iuryeng/TecProto/projetoShield/interfaceGrafica.png

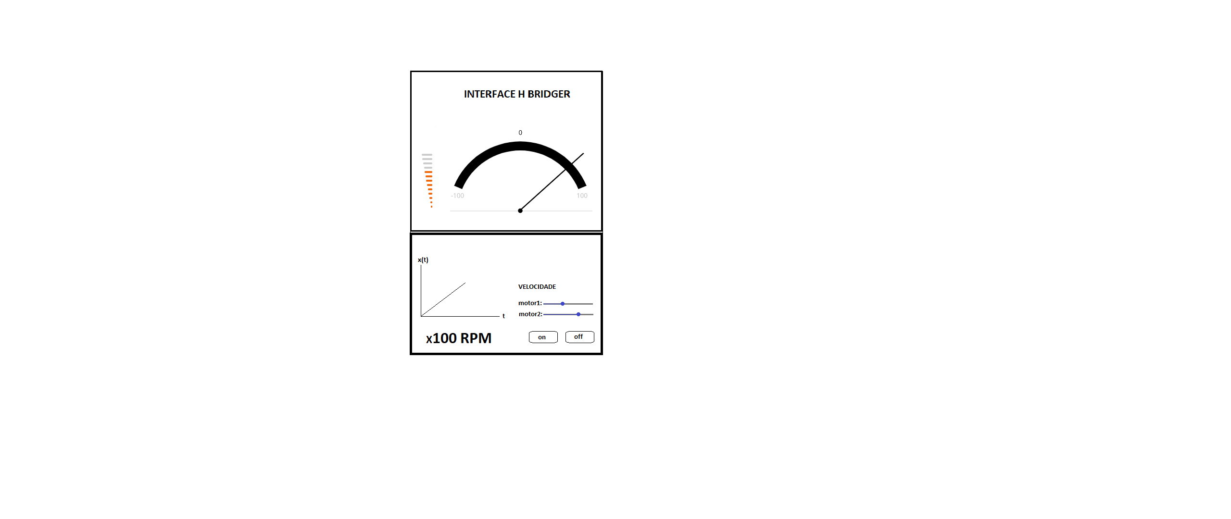
projetoShield/interfaceGrafica.png
