iuryeng/TecProto/(list of files, drawings)

Other design files:
projetoShield/shielCertoOK.pdsprj
projetoShield/SimulacaoPonte.pdsprj
